andres-leon/wireless-water-detector/images/2019-04-01 16.34.01.jpg

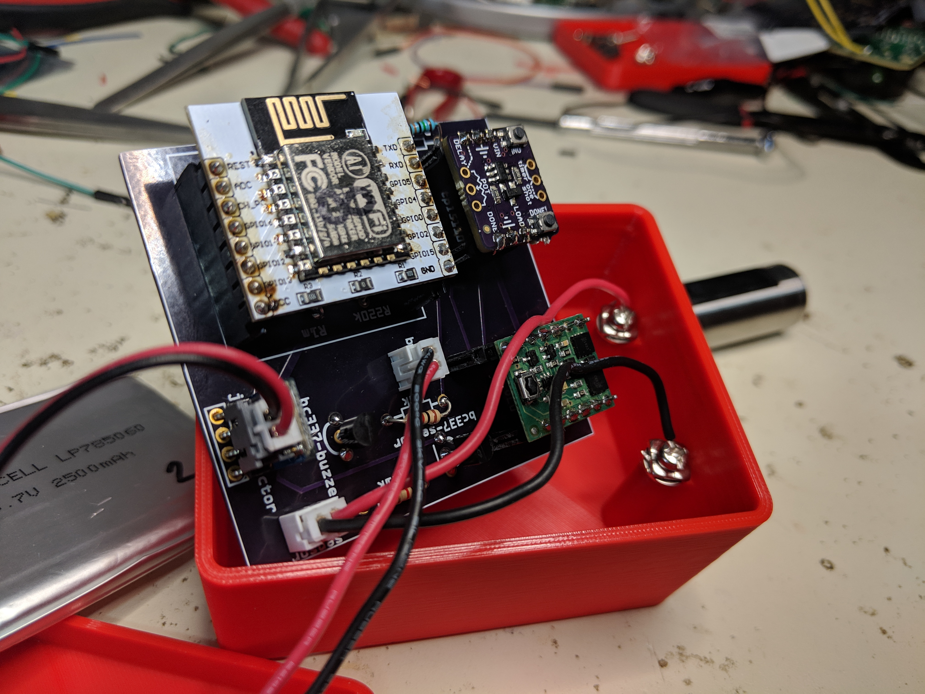
images/2019-04-01 16.34.01.jpg
